rickbronson/RC-Car-Camera/README.md

  Radio Control Monster Truck with Camera and Flashlight
==========================================

So I thought it might be fun to take an RC truck and add a Wyze V2 camera and a flashlight.  The Wyze V2 runs Linux and has WiFi so it controls the car via the RX2 chip that is so prevalent on RC cars and trucks.  I converted the remote control to a ESP8266 module so that it can talk to the Wyze V2 (through a router of course) and run the car.  The remote control runs an Arduino sketch (tcp-joystick/tcp-joystick.ino) to send commands via TCP to the Wyze V2.

  I modified the Wyze and added a 5 pin header to it that comes outside the camera:

 - Ground
 - TX (GPIO 55)
 - RX (GPIO 56)
 - +5 volts
 - Button (not used)

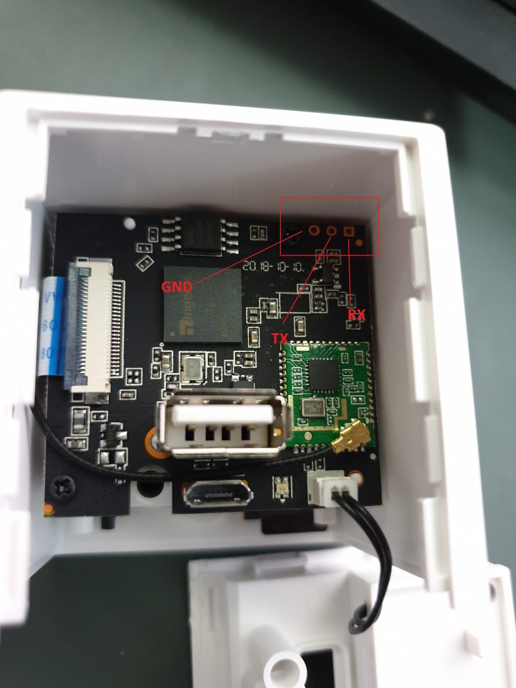
[picture p1: docs/hardware/Xiaomi-xiaofang-S1-768x1024.jpg]
Serial port


 The TX line gets set to a GPIO and sends a serial stream (see docs/hardware/RX-2B.pdf) to the RX2 chip that is used on the truck to receive the 49 MHz signal from the remote control.  The data flow goes like this: tcp-joystick/tcp-joystick.ino (running on ESP8266 on remote) sends commands (forward, backward, left, right) to scripts/getjoystick.c (running on the T20 chip on the Wyze V2) which writes commands to /sys/devices/platform/jz-tcu/cmd, this send commands to the driver at drivers/mfd/jz_tcu.c which is a timer interrupt running at 2000 Hz.  This driver streams RX2/TX2 commands to the RX2 chip on the truck.  A modification was made to the OS clock driver for this purpose.  This driver was also modified to provide a file (/sys/devices/platform/jz-tcu/cmd) to provide a means to write send commands to the RX2 chip.  A C program (scripts/getjoystick.c) runs upon boot up to take commands from the remote control via TCP.  You will need to modify this program to put your remote control's IP address in.

 - Get this git repo and the toolchain:

```
cd <somewhere>
git clone https://github.com/rickbronson/RC-Car-Camera.git
cd RC-Car-Camera/
git clone https://github.com/Dafang-Hacks/mips-gcc472-glibc216-64bit.git
mkdir -p Dafang-Hacks/Main
ln -s $PWD/mips-gcc472-glibc216-64bit Dafang-Hacks/Main/toolchain
```

 - Now we need modify the u-boot env variables on a Wyze V2 (Without installing
  new u-boot)

 - Take apart the camera and hook up serial port and log into root.  If you want to go through this whole thing, make a slot in the case and bring 4 pins out to a header that's glued in to the slot.  The four pins consist of: GND, TX, RX, +5v

 - Below we are going to put fw_printenv and the default environment
   variable file in /tmp, then create the config file for fw_setenv,
   and finally set the u-boot environment variables.  Note that
   env-orig.txt contains the original u-boot environment variables and
   env-sd.txt contains the u-boot environment variables modified to
   boot from the SD card.

```
cd /tmp
wget https://github.com/rickbronson/RC-Car-Camera/raw/master/rootfs/bin/fw_printenv
chmod 755 fw_printenv
ln -s fw_printenv fw_setenv

cat > fw_env.config << EOF
# MTD_device_name   Device_offset   Env_size   Flash_sector_size Number_of_sector
/dev/mtd0 0x3c000 0x4000 0x8000 1
EOF

wget https://github.com/rickbronson/RC-Car-Camera/raw/master/env-sd.txt
wget https://github.com/rickbronson/RC-Car-Camera/raw/master/env-orig.txt
./fw_setenv -s env-sd.txt
```

 - Now you can check to see that the u-boot env var's got set:

```
./fw_printenv
```

 - Now reboot (type the command "reboot") and check that you no longer
see:

*** Warning - bad CRC, using default environment

  Just below the line:

SF: Detected GD25Q128

  when u-boot comes up.

  This means that u-boot has read the env var's out of the serial
flash chip.  Now you can modify env-orig.txt above and tweak to your
hearts content.

  Notes:

  - You still can't save env var's in u-boot via the "setenv"
    command.  You have to use the method above to do that.

  - I've only tested this on a Wyze V2 so use caution on other
    devices.

 - Grab a 16BG SD card (or larger) and use the target "mksdcard" in the main Makefile to make up an SD card.  You might have to change some things (like /dev/sdb).  You might have to unplug the card and re-plug it at the "sleep" line in the mksdcard target.

 - Wireup the ESP8266 into the remote control.

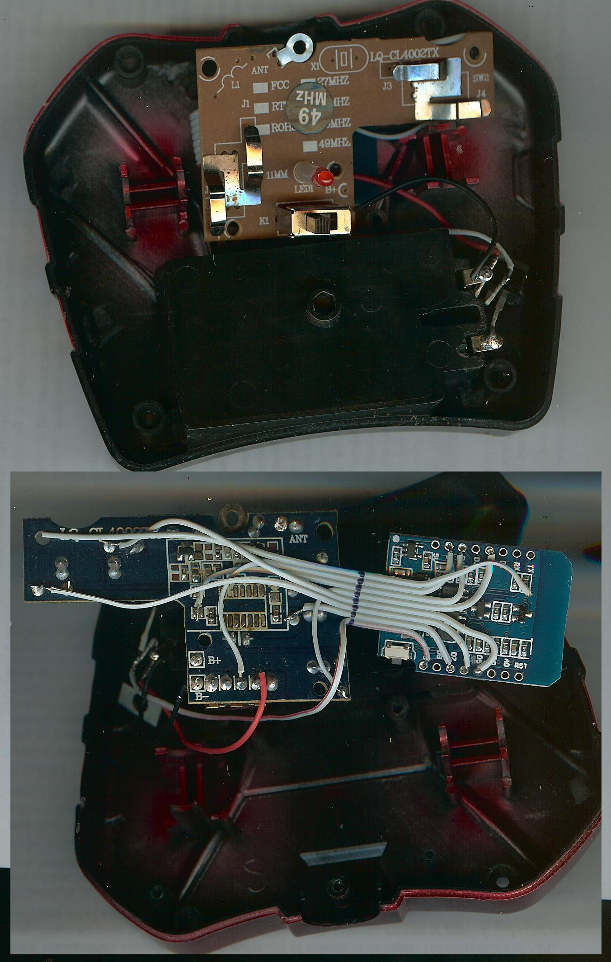
[picture p2: docs/hardware/joystick-mod1.png]
Joystick mod

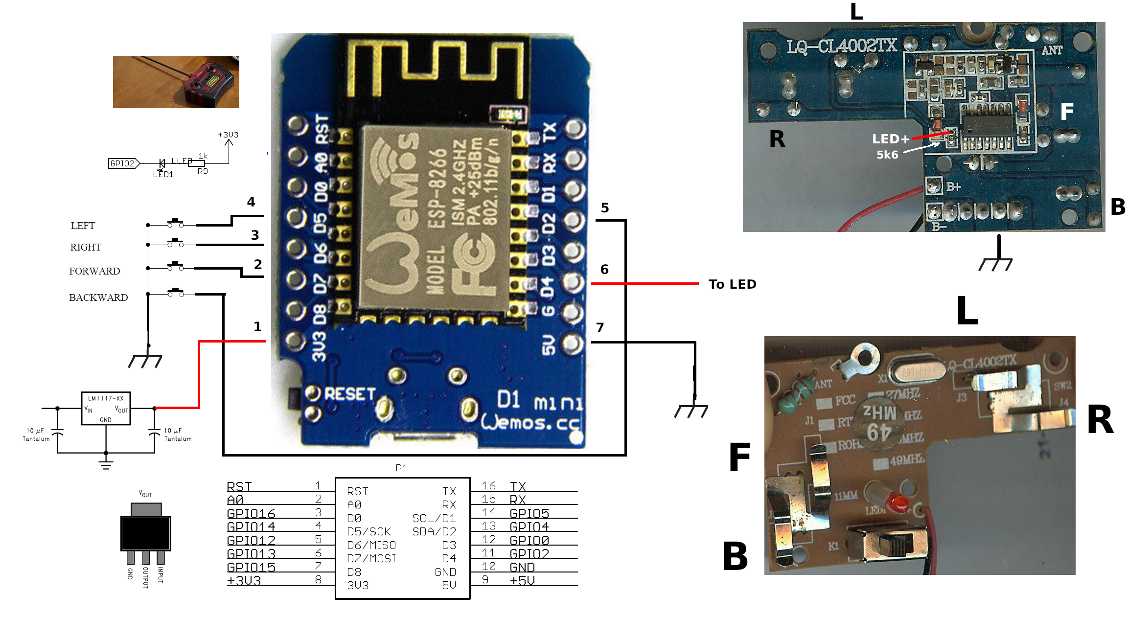
[picture p3: docs/hardware/joystick6.png]
Joystick hookup


 -  Modify the following lines in tcp-joystick/tcp-joystick.ino:
 
```
const char *ssid = "XXXXX";  //Enter your wifi SSID
const char *password = "XXXXXXXXXX";  //Enter your wifi Password
```
  and compile the sketch.  Upload into the ESP8266.

 - Attach the camera to the chassis of the RC truck, wire up a power bank to run the camera.

 - Attach a battery holder with batteries (I used 18650's) to run the motor (or just use the batteries already on the truck).  I tried using a power bank but the motors draw so much peak current, they shut the power bank down.

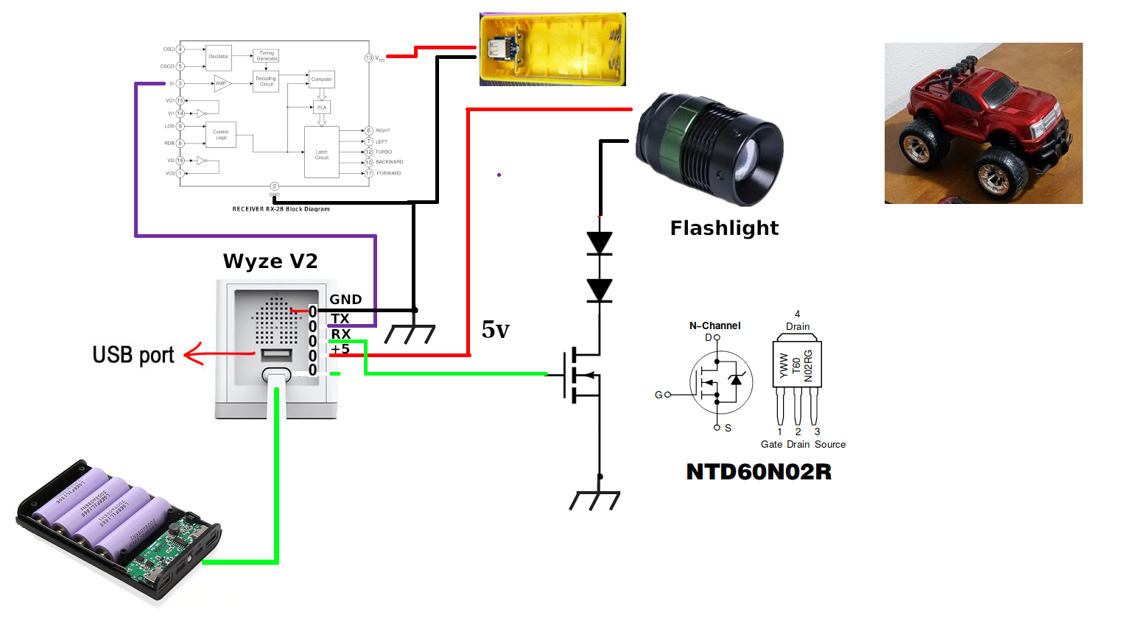
[picture p4: docs/hardware/rc-truck10.png]
Truck hookup


 - Modify getjoystick.c with your remote control's IP address, build and send to the Wyze V2 (modify the IP address below to your Wyze-V2's):

```
cd scripts
make getjoystick
scp scripts/getjoystick root@192.168.2.6:/usr/bin
```

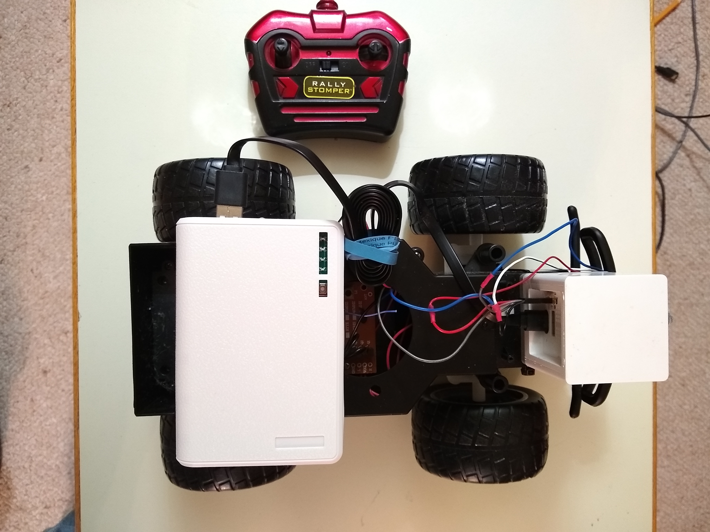
[picture p5: docs/hardware/truck-top1.jpg]
Truck top1

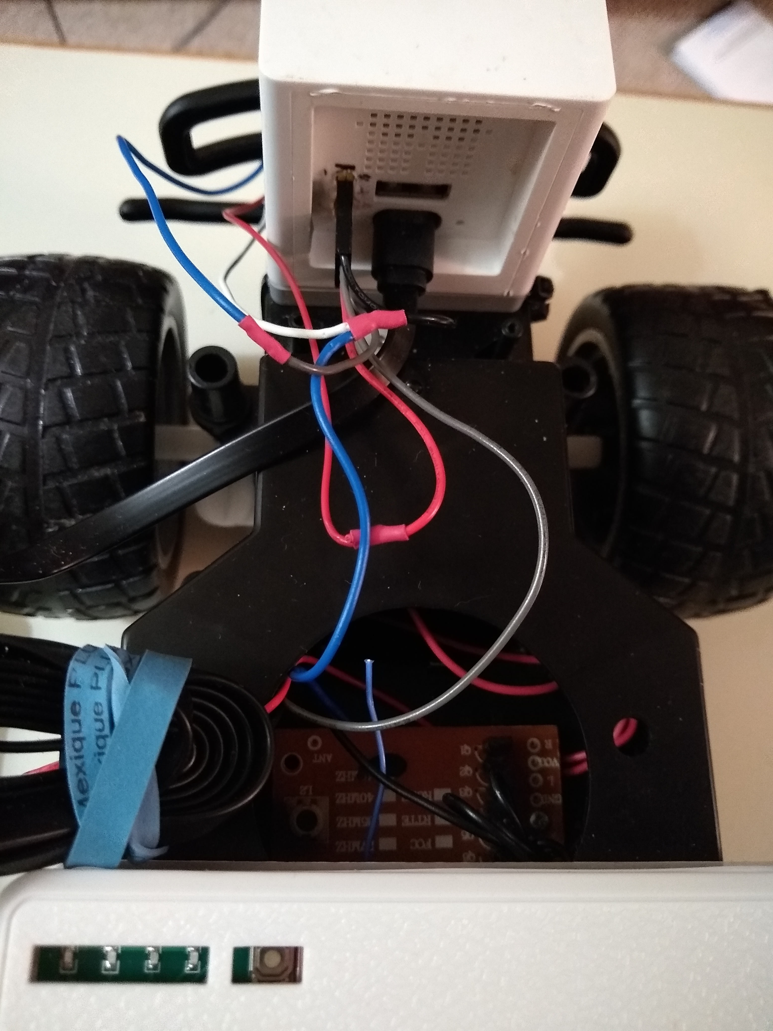
[picture p6: docs/hardware/truck-camera.jpg]
Truck camera

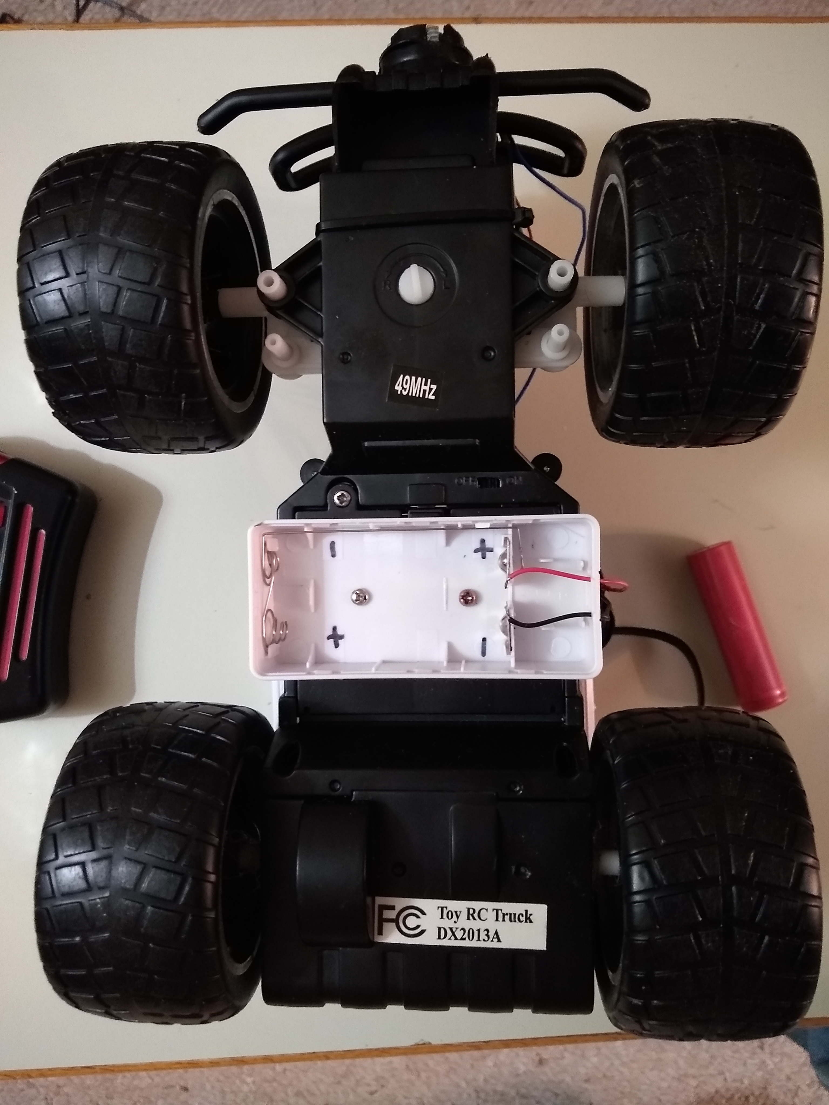
[picture p7: docs/hardware/truck-bottom.jpg]
Truck bottom

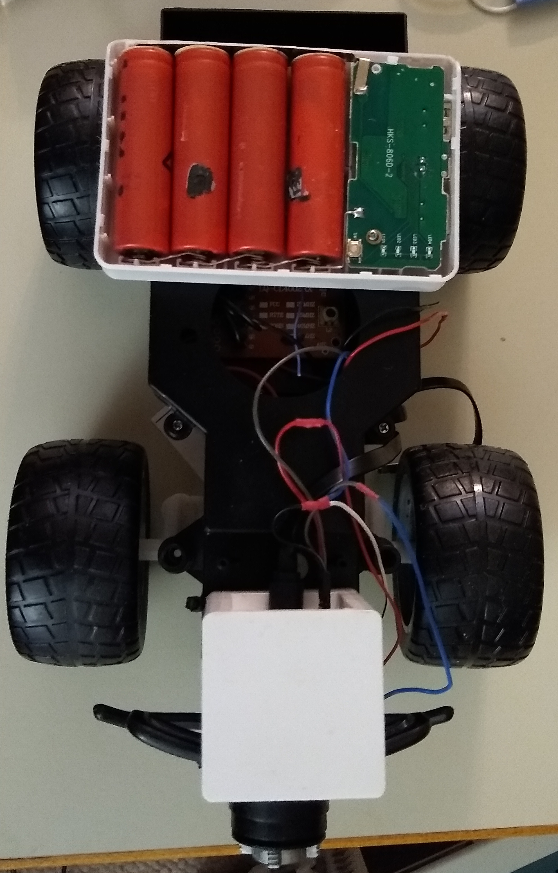
[picture p8: docs/hardware/truck-top2.jpg]
Truck top2


 - Comments/suggestions

  Please contact me at rick AT efn DOT org
